dstrmberg/etf_blinky/hardware/Manufacturing/etf_blink.TXT

M48
;Layer_Color=9474304
;FILE_FORMAT=2:4
INCH,TZ
;TYPE=PLATED
T01F00S00C0.0079
T02F00S00C0.0315
T03F00S00C0.0394
T04F00S00C0.0866
%
T01
X-1161Y4547
X-957
X-752
Y4752
X-957Y4752
X-1161Y4752
X-602Y4213
X917Y4213
X925Y5061
X1114Y5451
X1319
X1524
Y5656
X1319
X1114
X-555Y6091
X-1374Y6752
X-1374Y6957
X-1374Y7161
X-1374Y7366
X-1374Y7571
X-1374Y7776
X-1374Y7980
X-1374Y8185
X-1374Y8390
X1114Y8065
X1319
X1524
X1524Y7860
X1319Y7860
X1114
X1520Y10240
X3944Y10263
X3464Y9390
X6294Y10263
X4617Y6642
X4052Y1912
X3548Y1361
X7087Y5906
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
