dstrmberg/etf_blinky/docs/media/Resistor.dxf

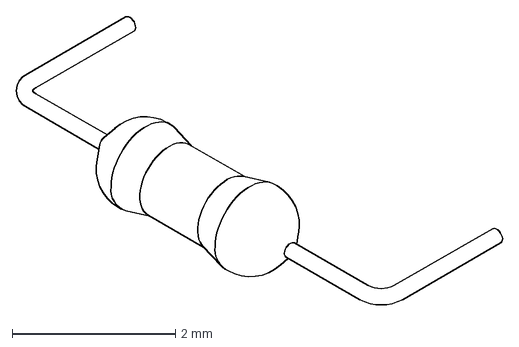
[picture p1: CAD file, 2024-09-20]
docs/media/Resistor.dxf
5.95 x 3.55 mm
