dstrmberg/etf_blinky/docs/media/Socket-8.dxf

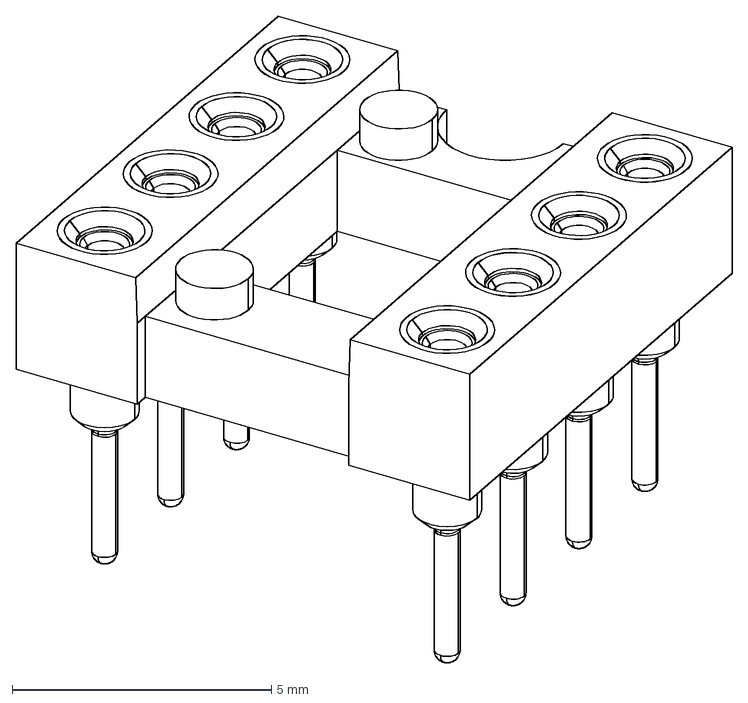
[picture p2: CAD file, 2024-09-20]
docs/media/Socket-8.dxf
13.8 x 12.5 mm
