dstrmberg/etf_blinky/docs/media/Electret microphone.dxf

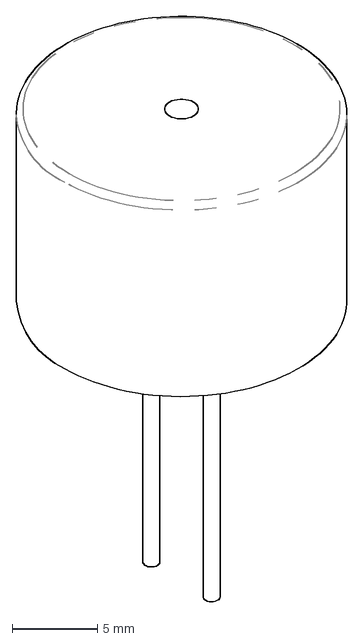
[picture p3: CAD file, 2024-09-20]
docs/media/Electret microphone.dxf
19.4 x 34.3 mm
