dstrmberg/etf_blinky/docs/media/Socket-14.dxf

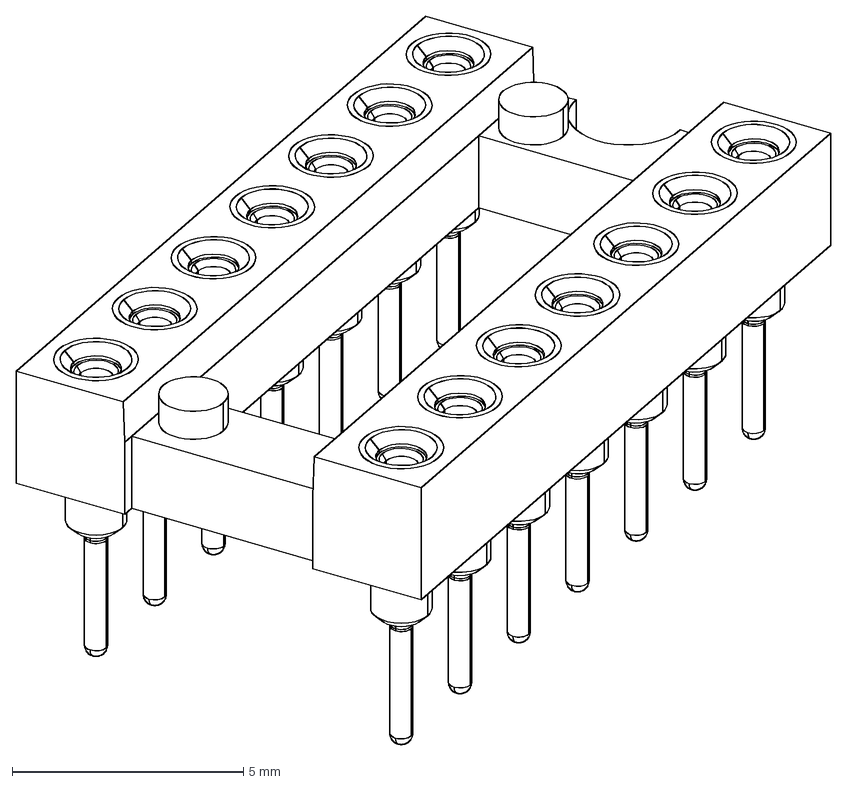
[picture p4: CAD file, 2024-09-20]
docs/media/Socket-14.dxf
17.6 x 15.7 mm
