dstrmberg/etf_blinky/docs/media/tac-button.dxf

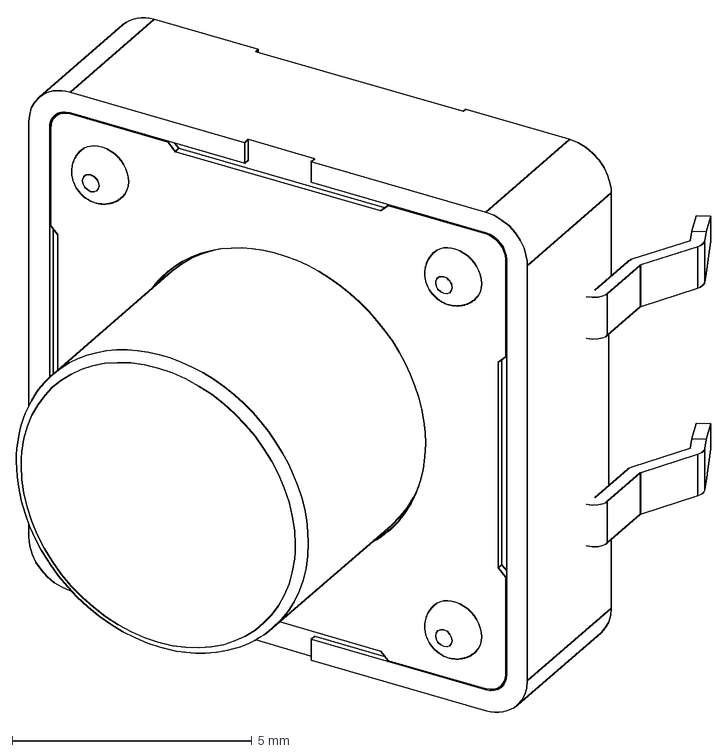
[picture p5: CAD file, 2024-09-20]
docs/media/tac-button.dxf
14.5 x 14.6 mm
