dstrmberg/etf_blinky/docs/media/Capacitor.dxf

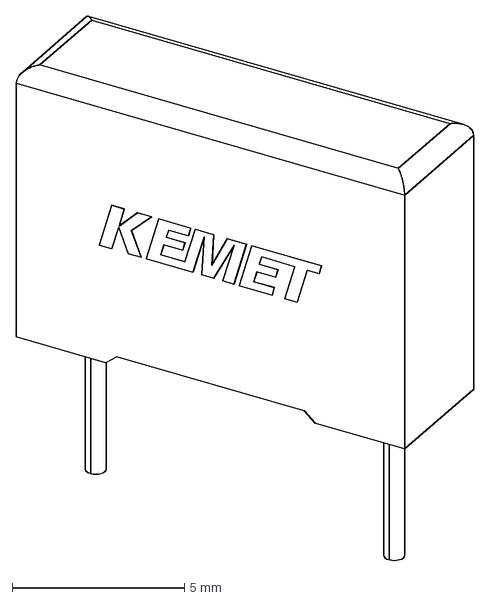
[picture p6: CAD file, 2024-09-20]
docs/media/Capacitor.dxf
13.3 x 15.8 mm
