dstrmberg/etf_blinky/docs/Disco Lights Manual.pdf

# Discø Lights

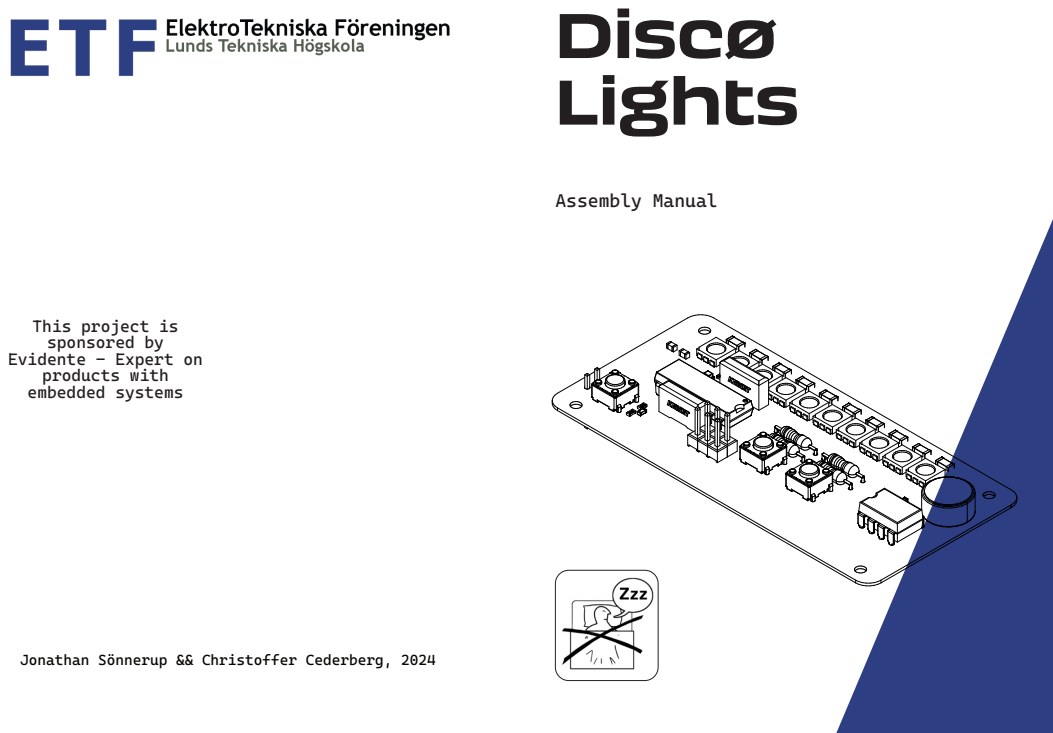
[picture p7: page 1]
Assembly Manual

This project is
sponsored by
Evidente - Expert on
products with
embedded systems

Jonathan Sönnerup && Christoffer Cederberg, 2024

1
2

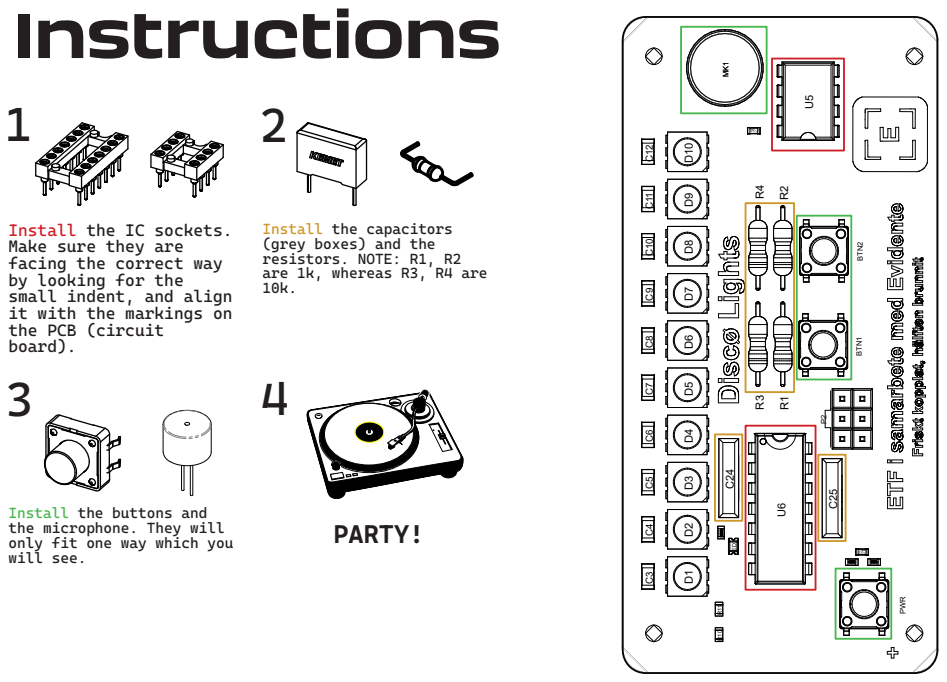
[picture p8: page 2]

Install the IC sockets.
Make sure they are
facing the correct way
by looking for the
small indent, and align
it with the markings on
the PCB (circuit
board).

Install the capacitors
(grey boxes) and the
resistors. NOTE: R1, R2
are 1k, whereas R3, R4 are

Install the buttons and
the microphone. They will
only fit one way which you
will see.
