dstrmberg/etf_blinky/simulation/Audio peak detector with filter.asc

C1: cap; 10µ
C2: cap; 10µ
C3: cap; 1n
C4: cap; 10µ
C5: cap; 1µ
D1: diode; 1N914
R1: res; 56k
R2: res; 100k
R3: res; 100k
R4: res; 100k
R5: res; 500k
R6: res; 100k
R7: res; 10k
R8: res; 1k
R12: res; 1k
R14: res; 1k
U1: UniversalOpAmp2
U2: UniversalOpAmp2
V1: voltage; SINE(0 .001 2000); AC 2
V2: voltage; 5
V3: voltage; PULSE(0 3.3 2m 1n 1n 2m 4m)
V4: voltage; SINE(0 2m 1)
Named nets: 0, Vcc, Vout1, Vpulse, Vin_HP
"MIC"
Control signal from uC, to reset the S/H circuit
.tran 0 1000m 900m .01m
