dstrmberg/etf_blinky/(list of files, drawings)

Other design files:
hardware/audio.SchDoc
hardware/etf_blink.PcbDoc
hardware/etf_pwr.SchDoc
hardware/make_etf_great_again.PrjPcb
hardware/make_etf_great_again.SchDoc
hardware/mcu.SchDoc
hardware/sk9822.SchDoc
