dstrmberg/etf_blinky/firmware/src/pattern.h

#pragma once

#include "dl_utils.h"


typedef void (*patternFunc)(void);


void patternInit(void);
bool patternBootSequence(void);
bool patternShutdownSequence(void);
void patternBatteryLevel(uint8_t level);
patternFunc patternNext(void);
patternFunc patternPrevious(void);
void patternNextColor(void);
void patternPreviousColor(void);
void patternIncreaseIntensity(void);
void patternDecreaseIntensity(void);
