dstrmberg/etf_blinky/(commit log)

2023-08-26 Schematic and layout almost done.
    [auido.SchDoc, etf_blink.PcbDoc, etf_pwr.SchDoc, make_etf_great_again.PrjPcb, make_etf_great_again.SchDoc, mcu.SchDoc, sk9822.SchDoc]
2023-08-27 Made changes to the analog part
    [auido.SchDoc, etf_blink.PcbDoc, make_etf_great_again.PrjPcb, mcu.SchDoc]
2023-09-05 Added review comments
    [auido.SchDoc, etf_pwr.SchDoc, make_etf_great_again.SchDoc, mcu.SchDoc]
2023-09-13 Added LTspice simulation of peak detector and filter circuit.
2023-09-13 Changed schematic in accordance to the simulation.
    [auido.SchDoc, etf_pwr.SchDoc, make_etf_great_again.PrjPcb]
2023-09-17 Layout done except footprint for the mic and battery connector#.
    [auido.SchDoc, etf_blink.PcbDoc, etf_pwr.SchDoc, make_etf_great_again.PrjPcb]
2023-09-17 Added some silkscrean text.
    [etf_blink.PcbDoc]
2023-09-18 Fixed port IO. Added electret mic. Added some text to PCB. DRC NO pass
    [auido.SchDoc, etf_blink.PcbDoc, etf_pwr.SchDoc, make_etf_great_again.PrjPcb, make_etf_great_again.SchDoc, mcu.SchDoc, sk9822.SchDoc]
2023-09-25 Ready to release!
    [etf_blink.PcbDoc]
2023-09-26 Removed review notes, added title and author
    [auido.SchDoc, etf_pwr.SchDoc, make_etf_great_again.PrjPcb, make_etf_great_again.SchDoc, mcu.SchDoc, sk9822.SchDoc]
2023-09-26 Renamed auido->audio, added gerber and drill files
    [audio.SchDoc, auido.SchDoc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]
2023-09-29 Fabriacated version. Revison 1.
    [etf_blink.PcbDoc, etf_pwr.SchDoc, make_etf_great_again.PrjPcb, make_etf_great_again.SchDoc, mcu.SchDoc, sk9822.SchDoc]
2023-11-04 Added firmware folder with a simple test application.
    [mcu.SchDoc]
2023-11-05 Do not track binary files
2023-11-06 Major refactor. Added premake buildsystem. Added race condition guards in ADC
2023-11-06 Do not track IDE-specific files
2023-11-23 Added correct toolset to premake file, do not track makefiles, they are generated by premake
2023-12-16 Tested HW rev 1, with self-power
2023-12-16 NOW the merge conflict is fixed.
    [adc.c, adc.h]
2024-01-11 Hardware: Fixed issue with the buttons.
    [etf_blink.PcbDoc, make_etf_great_again.SchDoc, mcu.SchDoc]
2024-01-11 Software: Added code for pin change interrupt for the buttons.
2024-01-11 Found bug, testing, wip
    [button.c, button.h, discolights.c, scheduler.c, scheduler.h, sys.c]
2024-04-23 Added the diode D12.
    [Pick Place for etf_blink.csv, audio.SchDoc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]
2024-05-04 Testing LEDs, working, wip
2024-05-04 Added basic patterns, and polling buttons to cycle between patterns. TODO: make it interrupt driven
2024-05-04 Revision 1.1 up for review.
    [audio.SchDoc, etf_blink.PcbDoc, etf_pwr.SchDoc, make_etf_great_again.SchDoc, mcu.SchDoc]
2024-05-05 DRC done! :)
    [etf_blink.PcbDoc, etf_pwr.SchDoc]
2024-05-05 Revision 1.1 done
    [Pick Place for etf_blink.csv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]
2024-07-03 Testing power issues
2024-07-07 testing power up sequence, wip
2024-09-04 Some BOM work done. Checked availability on JLC.
    [audio.SchDoc, etf_blink.PcbDoc, etf_pwr.SchDoc, make_etf_great_again.SchDoc]
2024-09-05 Updated resistor value on peak detector to have correct time constant
    [audio.SchDoc, etf_blink.PcbDoc, make_etf_great_again.PrjPcb]
2024-09-08 BOM changes.
    [audio.SchDoc, etf_pwr.SchDoc, mcu.SchDoc]
2024-09-09 BOM and assembly stuff
    [Pick Place for etf_blink.csv, audio.SchDoc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]
2024-09-10 BOM and P&P done.
    [audio.SchDoc, make_etf_great_again.PrjPcb]
2024-09-10 Changed JLC part number to correct value for 100n cap
    [audio.SchDoc, make_etf_great_again.PrjPcb]
2024-09-11 Fixed OP amp resistor to be 0R, not NC. Generated latest manufacturing files
    [Bill of Materials-make_etf_great_again.xlsx, Pick Place for etf_blink.csv, audio.SchDoc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]
2024-09-14 Use full ADC range of 10 bits
2024-09-16 Fixed startup sequence, prevent booting if user releases button too early
    [adc.c, button.c, button.h, discolights.c, pattern.c, sys.c, timer.c]
2024-09-16 #1: Implemented shutdown task, which cancels if user releases button too early
2024-09-17 Fixed button init bug. Fixed pattern next/prev bug. Added handling of button events, wip
    [button.c, discolights.c, pattern.c]
2024-09-17 Changed event handler to return event codes instead of using func pointers. Some bugs left, wip
    [button.c, discolights.c, scheduler.c, scheduler.h]
2024-09-20 Added assembly drawings for docs
    [make_etf_great_again.PrjPcb]
2024-09-20 Added first draft of assembly manual
    [Capacitor.dxf, Electret microphone.dxf, Resistor.dxf, Socket-14.dxf, Socket-8.dxf, tac-button.dxf]
2024-09-20 #10: fixed scheduler naming. Updated button ISR code. Got a weird button bug, wip
    [button.c, button.h, discolights.c, pattern.h, scheduler.c, scheduler.h, sys.c]
2024-09-21 Removed hw dependent includes, and use standard type names like uintx_t instead of short names
    [scheduler.h]
2024-09-21 Added C flags to test suite, and thread sanitizer
2024-09-25 Solved button2 isr issue by disabling interrupts and reenable later in task, wip
    [button.c, discolights.c, sys.c]
2024-09-25 Fixed timer API
2024-09-25 Fixed sneaky bug that hung the MCU on boot. Check thy compiler warnings!
    [bb_spi.c]
2024-09-25 Cleaned up button code
2024-09-26 Added more button functions, we can now click both buttons to check battery, wip
2024-09-26 Fixed battery status check, and audio pattern bug, due to not switching ADC back to audio after battery
    [adc.c, adc.h, button.c, discolights.c, pattern.c, sys.c]
2024-09-28 #13: Added FSM to handle patterns and battery check. Light intensity is wip
2024-09-29 #13: Added led intensity functions, code is running pretty smooth
2024-09-29 Clean up, make set/clear leds static
2024-09-29 #15: Fixed timing issue with knight rider, wip
    [pattern.c]
2024-09-29 #15: Timing is good now, using 3 LEDs for the knight rider effect
2024-10-01 #17: Added color option, and changed intensity button combo, wip
2024-10-01 #16: Replaced a bunch of if statements with a loop for battery level
    [pattern.c]
2024-10-01 #18: Fixed battery level indicator, works seemingly fine
    [pattern.c, sys.c]
2024-12-14 Fixed colors, added smooth intensity controls
    [discolights.c, pattern.c, scheduler.c]
